Makerfabs/Industrial-grade-Soil-Remote-Monitor-V2/readme.md

# Makerfas Industrial-grade Soil Remote Monitor V2

```c++
/*
Version:		V1.1
Author:			Vincent
Create Date:	2023/7/25
Note:

*/
```
