Makerfabs/Industrial-grade-Soil-Remote-Monitor-V2/hardware/RS485-LoRa Wireless Station-V2.1.pdf

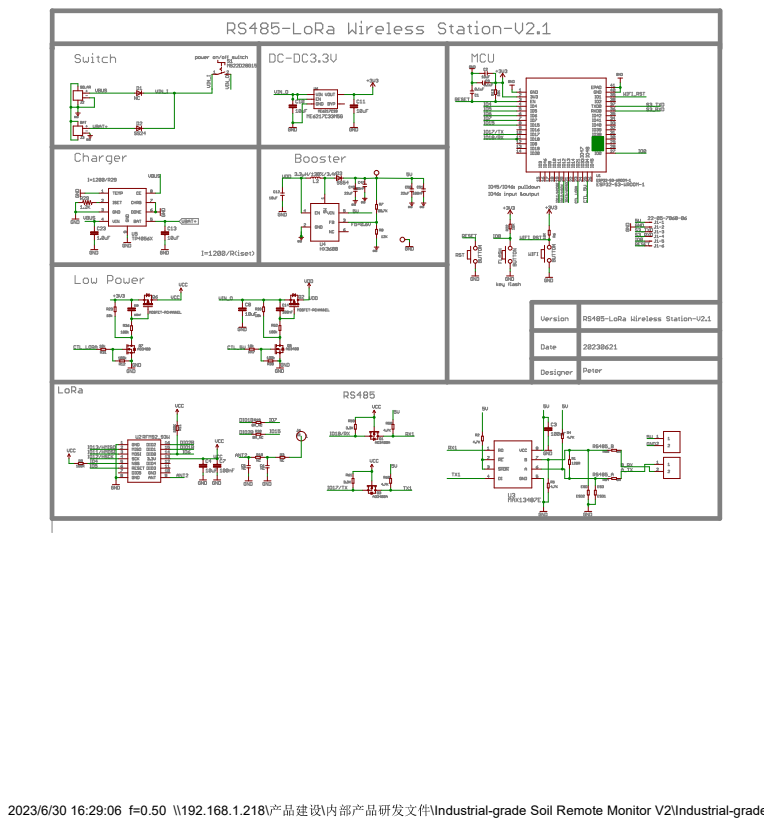
[picture p1: page 1]
\Industrial-grade Soil Remote Monitor V2\Industrial-grade
