Makerfabs/Industrial-grade-Soil-Remote-Monitor-V2/hardware/RS485-LoRa Wireless Station-V2.1.brd

## EAGLE design hardware/RS485-LoRa Wireless Station-V2.1.brd (2023-06-30)

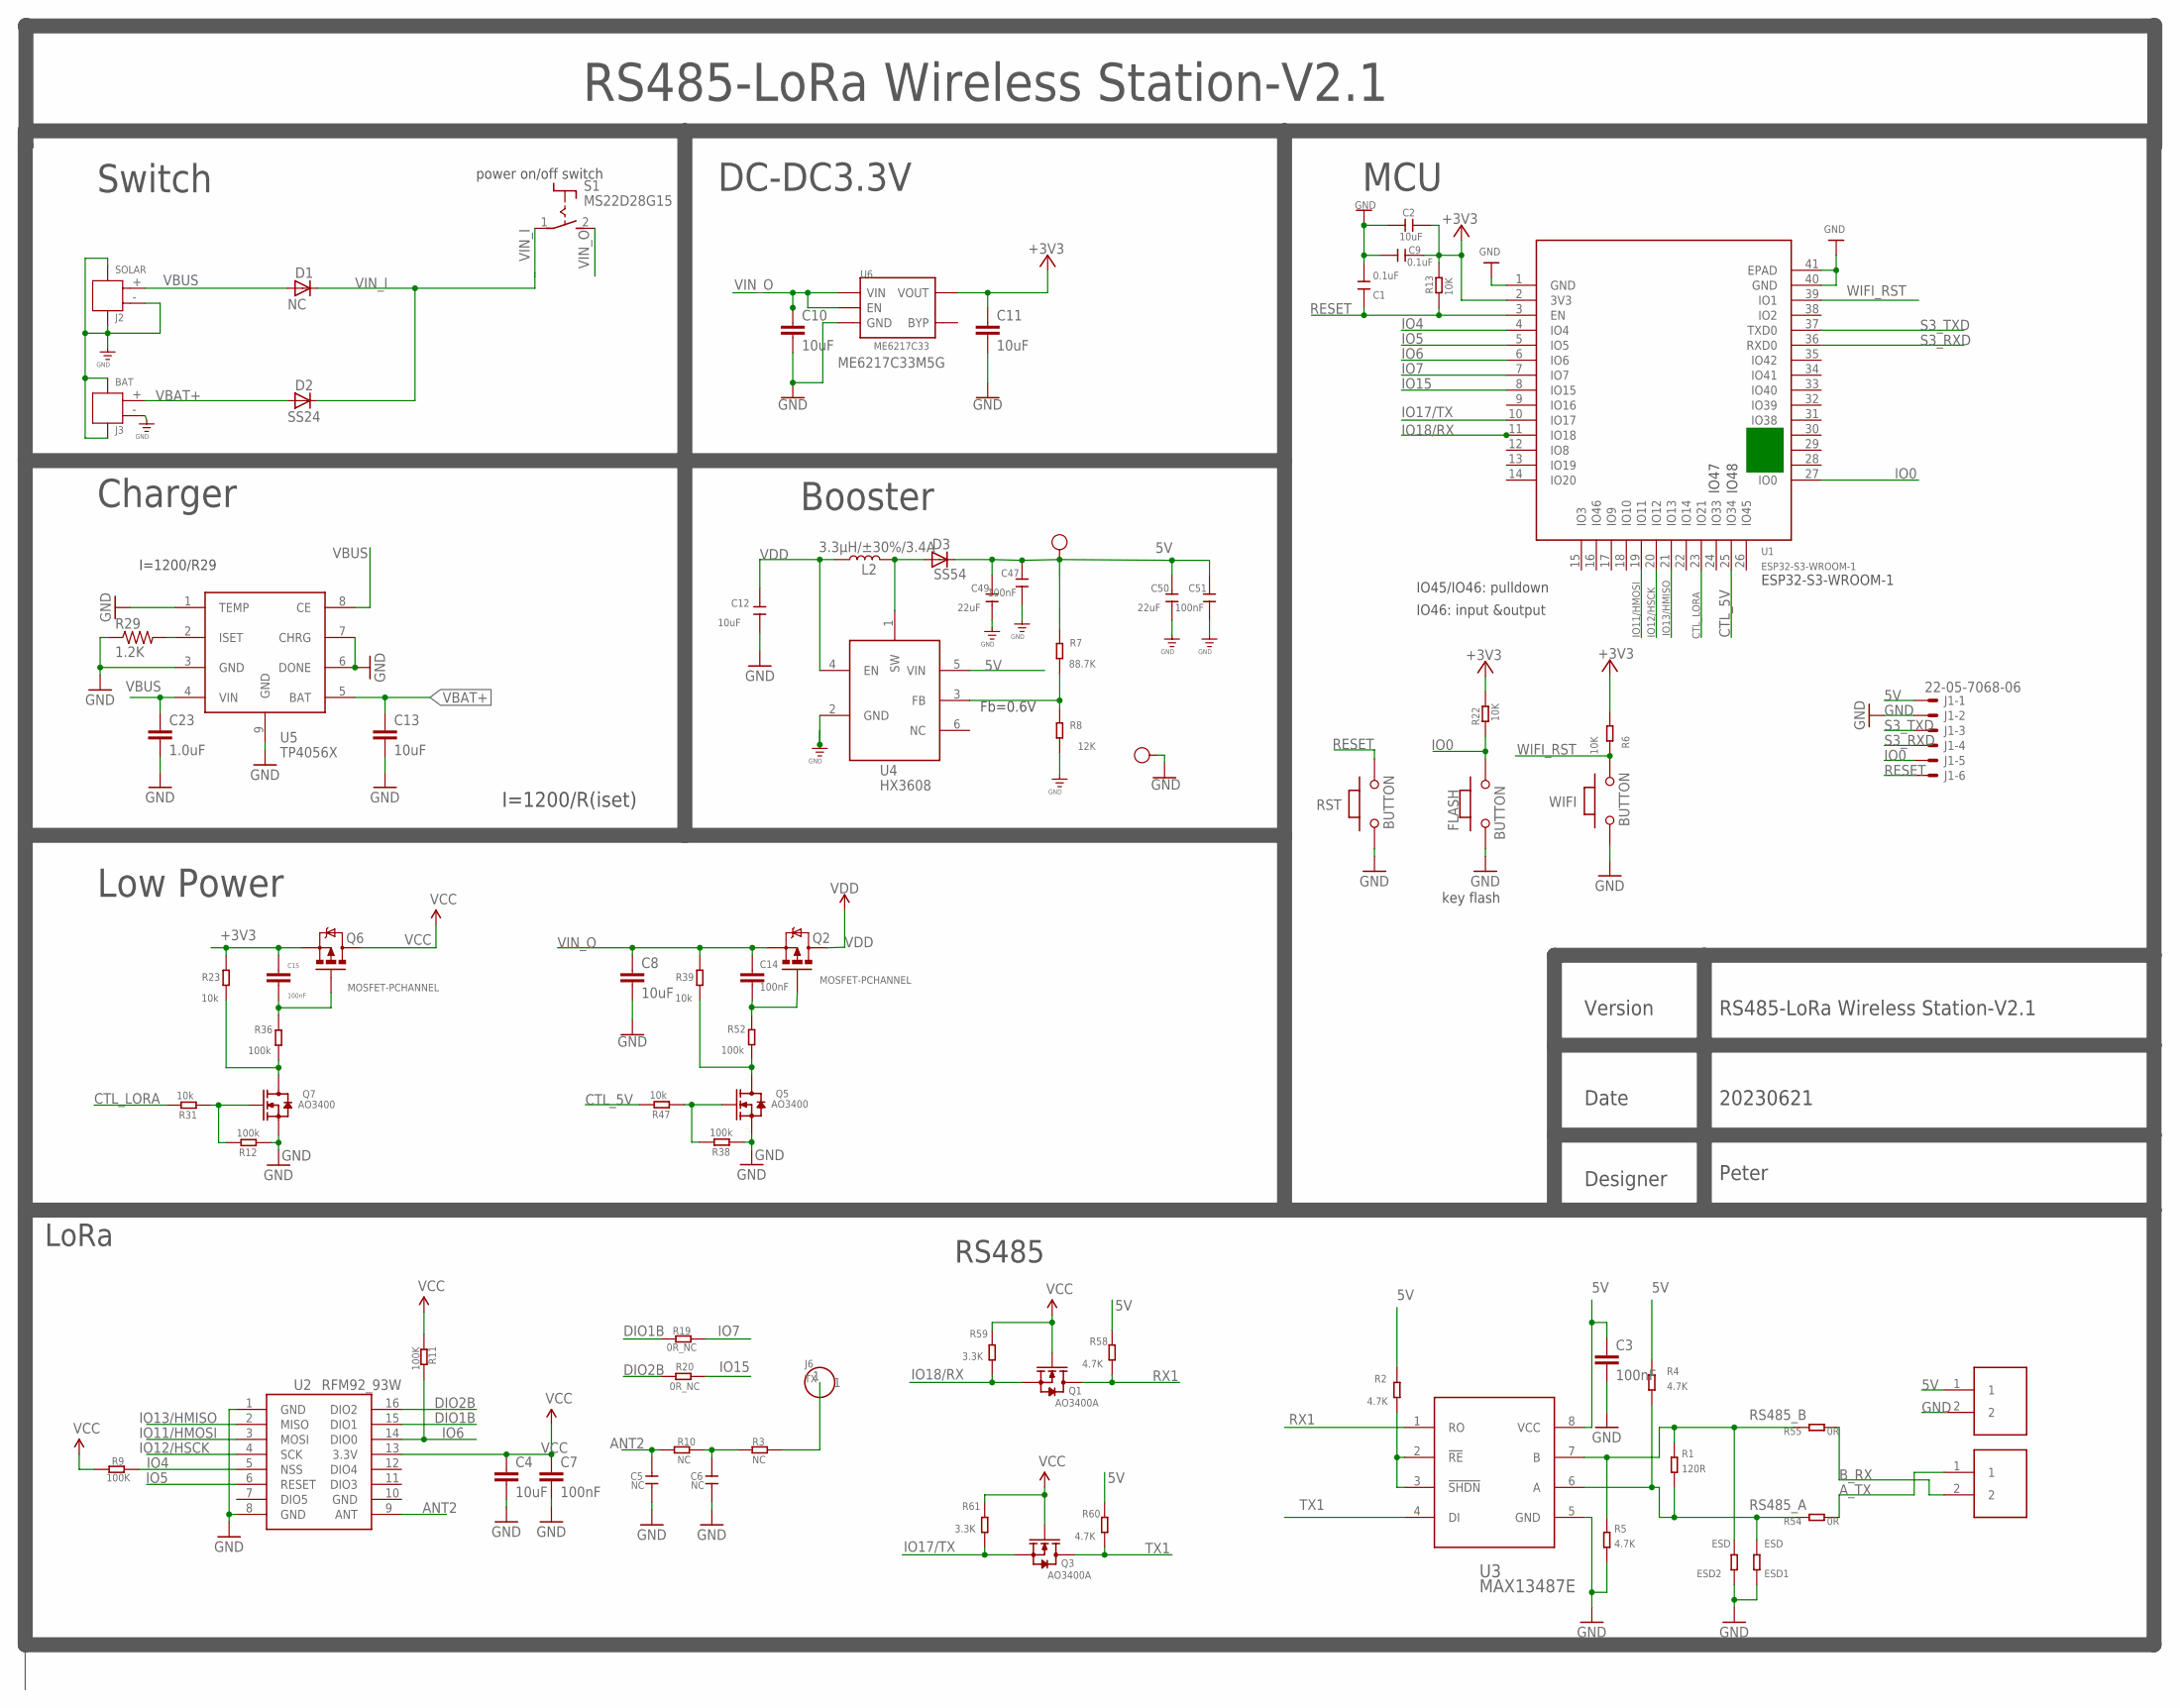
[picture p2: schematic RS485-LoRa Wireless Station-V2.1.sch]

Parts:
5V: HP; TP-D45MIL
C1, C9: 0.1uF; DISCRETE_C0603
C2: 10uF; DISCRETE_C0603
C3, C7, C14, C15, C47, C51: 100nF; C0603
C4, C8, C10, C11, C12, C13: 10uF; C0603
C5, C6: NC; DISCRETE_C0603
C23: 1.0uF; C0603
C49, C50: 22uF; C0603
D1: NC; DO-214AC
D2: SS24; DO-214AC
D3: SS54; DO-214AC
ESD1, ESD2: ESD; R0603
FLASH: BUTTON; 157SW
GND: HP; TP-D45MIL
J1: 22-05-7068-06; 7395-06
J2: SOLAR; HW2-SMD-2.0-90D
J3: BAT; HW2-SMD-2.0-90D
J4, J5: PH2.0-2P-DIP; PH2.0*2-DIP
J6: TX; 1P-100/50MIL
L2: 3.3µH/±30%/3.4A; CR54
Q1, Q3: AO3400A; SOT-23
Q2, Q6: MOSFET-PCHANNEL; SOT23-3
Q5, Q7: AO3400; SOT23@1
R1: 120R; R0603
R2, R4, R5, R58, R60: 4.7K; R0603
R3, R10: NC; DISCRETE_R0603
R6, R13, R22: 10K; R0603
R7: 88.7K; R0603
R8: 12K; R0603
R9, R11: 100K; R0603
R12, R36, R38, R52: 100k; R0603
R19, R20: 0R_NC; R0603
R23, R31, R39, R47: 10k; R0603
R29: 1.2K; R0603
R54, R55: 0R; R0603
R59, R61: 3.3K; R0603
RST: BUTTON; 157SW
S1: MS22D28G15; S-MS22D28G15
U1: ESP32-S3-WROOM-1; ESP32-­S2-­SOLO
U2: RFM92_93W
U3: MAX13487E; DIP8_MAX13487
U4: HX3608; SOT-23-6
U5: TP4056X; SOP8-1.27P
U6: ME6217C33; SOT23-5
WIFI: BUTTON; 157SW

Connections:
5V: 5V.T, C3.1, C47.1, C49.1, C50.1, C51.1, D3.C, J1.1, J4.1, R2.2, R4.2, R7.2, R58.2, R60.2, U3.8 (VCC), U4.5 (VIN)
+3V3: C2.1, C9.1, C11.1, C15.1, Q6.2 (S), R6.2, R13.2, R22.2, R23.2, U1.2 (3V3), U6.5 (VOUT)
ANT2: C5.2, R10.1, U2.9 (ANT)
A_TX: J5.1, R54.1
B_RX: J5.2, R55.1
CTL_5V: R47.2, U1.25 (IO34)
CTL_LORA: R31.2, U1.23 (IO21)
DIO1B: R19.2, U2.15 (DIO1)
DIO2B: R20.2, U2.16 (DIO2)
GND: C1.2, C2.2, C3.2, C4.2, C5.1, C6.1, C7.2, C8.2, C9.2, C10.2, C11.2, C12.2, C13.2, C23.2, C47.2, C49.2, C50.2, C51.2, ESD1.1, ESD2.1, FLASH.1, GND.T, J1.2, J2.3, J2.4, J2.- (2), J3.3, J3.4, J3.- (2), J4.2, Q5.2 (S), Q7.2 (S), R5.1, R8.1, R12.1, R29.1, R38.1, RST.1, U1.1 (GND), U1.40 (GND), U1.41 (EPAD), U2.1 (GND), U2.8 (GND), U2.10 (GND), U3.5 (GND), U4.2 (GND), U5.1 (TEMP), U5.3 (GND), U5.6 (DONE), U5.7 (CHRG), U5.9 (GND), U6.2 (GND), WIFI.1
IO0: FLASH.2, J1.5, R22.1, U1.27 (IO0)
IO4: R9.1, U1.4 (IO4), U2.5 (NSS)
IO5: U1.5 (IO5), U2.6 (RESET)
IO6: R11.1, U1.6 (IO6), U2.14 (DIO0)
IO7: R19.1, U1.7 (IO7)
IO11/HMOSI: U1.19 (IO11), U2.3 (MOSI)
IO12/HSCK: U1.20 (IO12), U2.4 (SCK)
IO13/HMISO: U1.21 (IO13), U2.2 (MISO)
IO15: R20.1, U1.8 (IO15)
IO17/TX: Q3.2 (S), R61.1, U1.10 (IO17)
IO18/RX: Q1.2 (S), R59.1, U1.11 (IO18)
ISET: R29.2, U5.2 (ISET)
unnamed: C6.2, R3.1, R10.2
unnamed: J6.1, R3.2
unnamed: C14.2, Q2.1 (G), R52.2
unnamed: Q5.1 (G), R38.2, R47.1
unnamed: C15.2, Q6.1 (G), R36.2
unnamed: Q7.1 (G), R12.2, R31.1
unnamed: Q7.3 (D), R23.1, R36.1
unnamed: D3.A, L2.P$2 (2), U4.1 (SW)
unnamed: R7.1, R8.2, U4.3 (FB)
unnamed: Q5.3 (D), R39.1, R52.1
unnamed: R2.1, U3.2 (!RE), U3.3 (!SHDN)
RESET: C1.1, J1.6, R13.1, RST.2, U1.3 (EN)
RS485_A: ESD1.2, R1.1, R4.1, R54.2, U3.6 (A)
RS485_B: ESD2.2, R1.2, R5.2, R55.2, U3.7 (B)
RX1: Q1.3 (D), R58.1, U3.1 (RO)
S3_RXD: J1.4, U1.36 (RXD0)
S3_TXD: J1.3, U1.37 (TXD0)
TX1: Q3.3 (D), R60.1, U3.4 (DI)
VBAT+: C13.1, D2.A, J3.+ (1), U5.5 (BAT)
VBUS: C23.1, D1.A, J2.+ (1), U5.4 (VIN), U5.8 (CE)
VCC: C4.1, C7.1, Q1.1 (G), Q3.1 (G), Q6.3 (D), R9.2, R11.2, R59.2, R61.2, U2.13 (3.3V)
VDD: C12.1, L2.P$1 (1), Q2.3 (D), U4.4 (EN)
VIN_I: D1.C, D2.C, S1.1
VIN_O: C8.1, C10.1, C14.1, Q2.2 (S), R39.2, S1.2 (S), U6.1 (VIN), U6.3 (EN)
WIFI_RST: R6.1, U1.39 (IO1), WIFI.2

Notes on the sheet:
DC-DC3.3V
I=1200/R29
ME6217C33M5G
Fb=0.6V
Charger
Booster
LoRa
RS485
power on/off switch
key flash
Switch
MCU
Low Power
IO45/IO46: pulldown
IO46: input &output
ESP32-S3-WROOM-1
IO47
IO48
I=1200/R(iset)
Version
Date
Designer
RS485-LoRa Wireless Station-V2.1
20230621
Peter

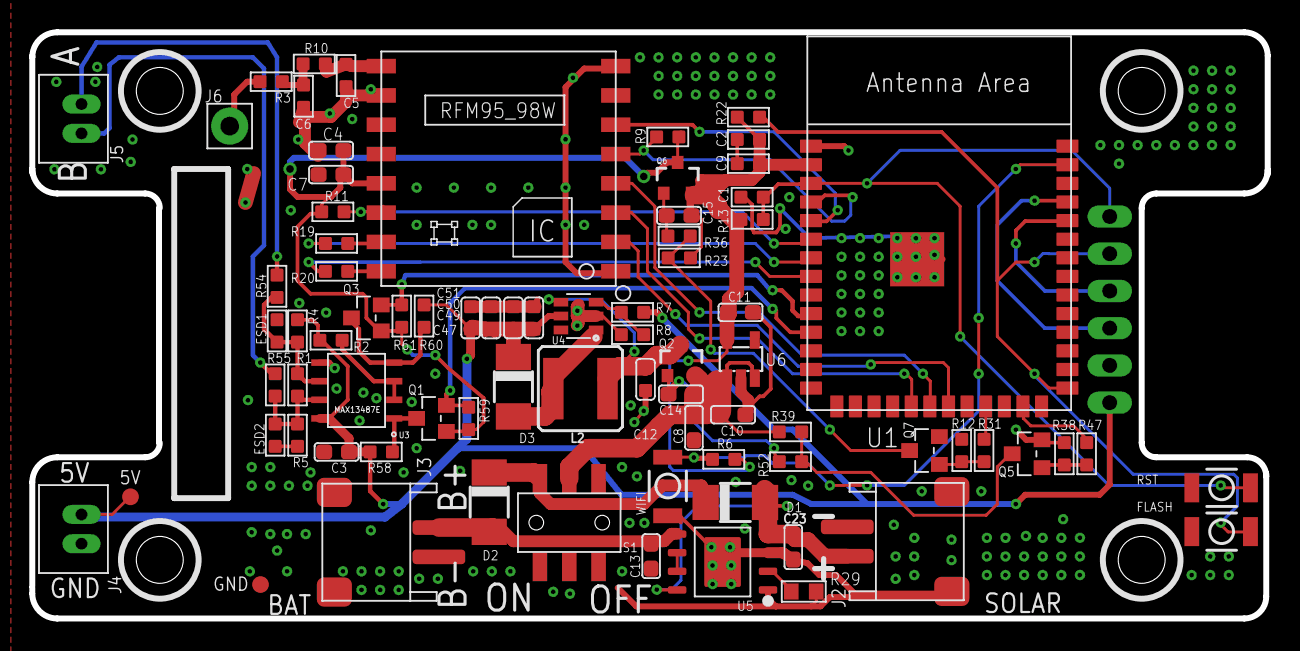
[picture p3: board RS485-LoRa Wireless Station-V2.1.brd from above]

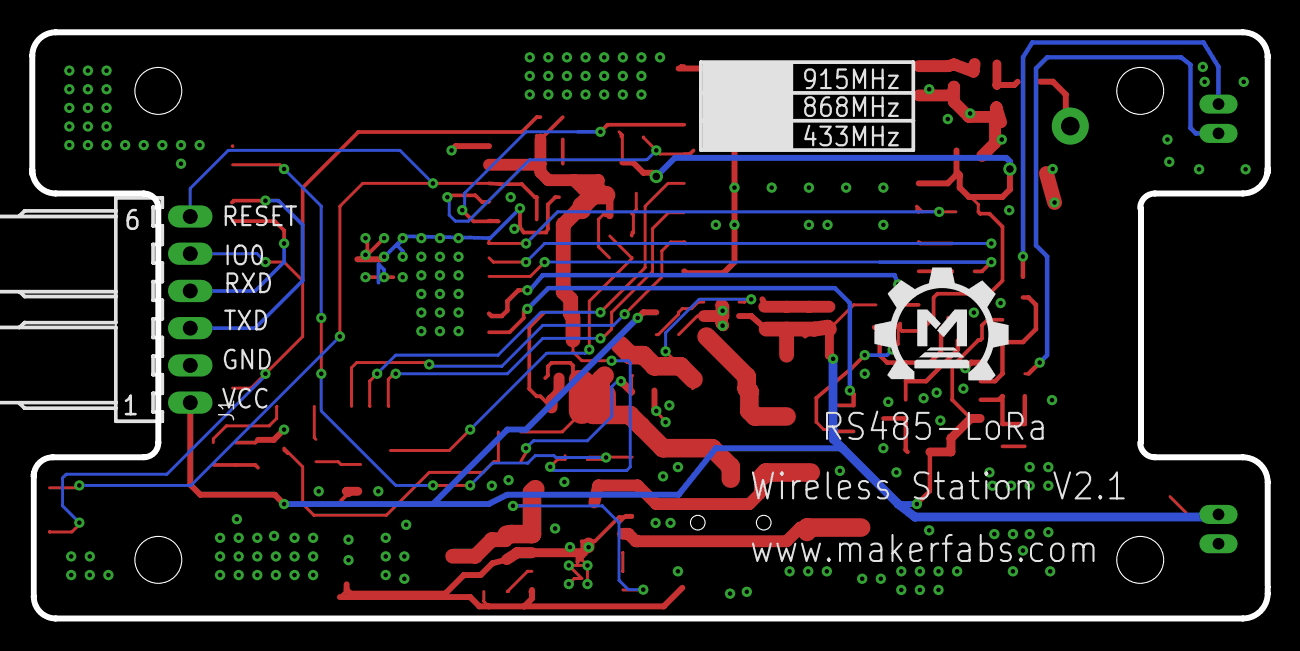
[picture p4: board RS485-LoRa Wireless Station-V2.1.brd from below]

Board: 2 copper layers, 84.3 x 40.0 mm, 81 parts (2 on the bottom side), 47 nets.

Other parts of the board:
U$3: MAKERFABS_0.3
