Makerfabs/Industrial-grade-Soil-Remote-Monitor-V2/(threads)

Thread 3 (2023-10-18):

Low power

tomascrespo, 2023-10-18:
Hi! I am trying to learn from your project

Do you cut off the power to the sensors when deep sleeping? How do you do? Low side (GND) or high side (Vcc) ?

I am looking at you schematic, but I would like your confirmation.

And... do you use some kind of snubber to avoid peaks from the soil sensor?

Lot of thanks
