Makerfabs/Industrial-grade-Soil-Remote-Monitor-V2/example/tft_receiver/makerfabs_pin.h

#ifndef _Makerfabs_Pin_H_
#define _Makerfabs_Pin_H_

#define DEBUG 0

#define SPI_MOSI 13
#define SPI_MISO 12
#define SPI_SCK 14

//TFT
#define LCD_MOSI SPI_MOSI
#define LCD_MISO SPI_MISO
#define LCD_SCK SPI_SCK
#define LCD_CS 15
#define LCD_RST 26
#define LCD_DC 33
#define LCD_BL -1

#define LCD_WIDTH 320
#define LCD_HEIGHT 480

#define SCRENN_ROTATION 3

//SD Card
#define SD_CS 4

#define SPI_ON_TFT 
#define SPI_OFF_TFT
#define SPI_ON_SD
#define SPI_OFF_SD 

//Lora
//HSPI
#define LORA_MOSI 23
#define LORA_MISO 19
#define LORA_SCK 18
#define LORA_CS 21

#define LORA_RST 22
#define LORA_DIO0 32
#define LORA_DIO1 35

#define FREQUENCY 868.0
#define BANDWIDTH 125.0
#define SPREADING_FACTOR 12
#define CODING_RATE 6
#define OUTPUT_POWER 20
#define PREAMBLE_LEN 8
#define GAIN 0


#endif
