Makerfabs/Industrial-grade-Soil-Remote-Monitor-V2/example/tft_receiver/log_save.h

#ifndef _Log_Save_H_
#define _Log_Save_H_

#include <SD.h>
#include <FS.h>

#include "makerfabs_pin.h"

void SD_init();
void listDir(fs::FS &fs, const char *dirname, uint8_t levels);
void readFile(fs::FS &fs, const char *path);
void writeFile(fs::FS &fs, const char *path, const char *message);
void appendFile(fs::FS &fs, const char *path, const char *message);
void checkFile(fs::FS &fs, const char *path);

#endif
