Makerfabs/Industrial-grade-Soil-Remote-Monitor-V2/(commit log)

2023-06-30 Update hardware
    [RS485-LoRa Wireless Station-V2.1.brd, RS485-LoRa Wireless Station-V2.1.sch]
2023-07-25 new arduino file without N/P/K
2024-06-27 Add battery detect
